sundaysiagian/peruri-iseedesign/robot/jetauto/PYTHON_FILE_CATALOG.md

# Inventaris seluruh file Python

Diambil dari ZIP pengguna. File hanya diparse, entry point ROS dan servo tidak dijalankan.

## original/jetauto_driver/hiwonder_servo/__init__.py

Imports: none

Functions: none

## original/jetauto_driver/hiwonder_servo/hiwonder_servo_controllers/scripts/__init__.py

Imports: none

Functions: none

## original/jetauto_driver/hiwonder_servo/hiwonder_servo_controllers/scripts/controller_manager.py

Imports: hiwonder_servo_controllers.action_group_runner, hiwonder_servo_controllers.joint_position_controller, hiwonder_servo_controllers.joint_trajectory_action_controller, hiwonder_servo_driver.hiwonder_servo_serialproxy, rospy

Functions: none

Class `ControllerManager` (line 9): __init__, on_shutdown, check_deps, start_position_controller, start_trajectory_action_controller, set_multi_pos

## original/jetauto_driver/hiwonder_servo/hiwonder_servo_controllers/scripts/joint_state_publisher.py

Imports: hiwonder_servo_msgs.msg, os, rospy, sensor_msgs.msg

Functions: none

Class `JointStateMessage` (line 8): __init__

Class `JointStatePublisher` (line 15): __init__, controller_state_handler, publish_joint_states

## original/jetauto_driver/hiwonder_servo/hiwonder_servo_controllers/setup.py

Imports: catkin_pkg.python_setup, distutils.core

Functions: none

## original/jetauto_driver/hiwonder_servo/hiwonder_servo_controllers/src/__init__.py

Imports: none

Functions: none

## original/jetauto_driver/hiwonder_servo/hiwonder_servo_controllers/src/hiwonder_servo_controllers/__init__.py

Imports: none

Functions: none

## original/jetauto_driver/hiwonder_servo/hiwonder_servo_controllers/src/hiwonder_servo_controllers/action_group_runner.py

Imports: actionlib, hiwonder_servo_msgs.msg, os, rospy, threading, ujson

Functions: none

Class `ActionGroupRunner` (line 12): __init__, get_actions_from_file, start, runner, process_action_group_run

## original/jetauto_driver/hiwonder_servo/hiwonder_servo_controllers/src/hiwonder_servo_controllers/bus_servo_control.py

Imports: hiwonder_servo_msgs.msg, rospy, signal

Functions: set_servos

## original/jetauto_driver/hiwonder_servo/hiwonder_servo_controllers/src/hiwonder_servo_controllers/joint_controller.py

Imports: hiwonder_servo_msgs.msg, rospy, std_msgs.msg

Functions: none

Class `JointController` (line 10): __init__, initialize, start, stop, process_servo_states, process_command_duration, process_command, rad_to_raw, raw_to_rad

## original/jetauto_driver/hiwonder_servo/hiwonder_servo_controllers/src/hiwonder_servo_controllers/joint_position_controller.py

Imports: hiwonder_servo_controllers.joint_controller, hiwonder_servo_msgs.msg, rospy

Functions: none

Class `JointPositionController` (line 7): __init__, initialize, pos_rad_to_raw, spd_rad_to_raw, process_servo_states, process_command, process_command_duration, set_position, set_position_in_rad

## original/jetauto_driver/hiwonder_servo/hiwonder_servo_controllers/src/hiwonder_servo_controllers/joint_trajectory_action_controller.py

Imports: actionlib, control_msgs.msg, rospy, threading, trajectory_msgs.msg

Functions: none

Class `Segment` (line 12): __init__

Class `JointTrajectoryActionController` (line 20): __init__, initialize, start, stop, process_command, process_follow_trajectory, process_trajectory, update_state

## original/jetauto_driver/hiwonder_servo/hiwonder_servo_driver/setup.py

Imports: catkin_pkg.python_setup, distutils.core

Functions: none

## original/jetauto_driver/hiwonder_servo/hiwonder_servo_driver/src/__init__.py

Imports: none

Functions: none

## original/jetauto_driver/hiwonder_servo/hiwonder_servo_driver/src/hiwonder_servo_driver/__init__.py

Imports: none

Functions: none

## original/jetauto_driver/hiwonder_servo/hiwonder_servo_driver/src/hiwonder_servo_driver/hiwonder_servo_io.py

Imports: os, ros_robot_controller.msg, ros_robot_controller.srv, rospy, sys, time

Functions: none

Class `servo_state` (line 12): __init__

Class `HiwonderServoIO` (line 20): __init__, ping, get_position, get_voltage, get_feedback, set_timeout, set_servo_id, get_servo_id, set_position, stop, set_servo_offset, save_servo_offset, get_servo_offset, set_servo_range, get_servo_range, set_servo_vin_range, get_servo_vin_range, set_servo_temp_range, get_servo_temp_range, get_servo_temp, get_servo_vin, reset_offset, enable_servo_torque, get_servo_torque, exception_on_error

Class `FatalErrorCodeError` (line 381): __init__, __str__

Class `NonfatalErrorCodeError` (line 390): __init__, __str__

Class `ErrorCodeError` (line 399): __init__, __str__

Class `DroppedPacketError` (line 408): __init__, __str__

Class `UnsupportedFeatureError` (line 416): __init__, __str__

## original/jetauto_driver/hiwonder_servo/hiwonder_servo_driver/src/hiwonder_servo_driver/hiwonder_servo_serialproxy.py

Imports: collections, hiwonder_servo_driver, hiwonder_servo_msgs.msg, os, ros_robot_controller.msg, ros_robot_controller.srv, rospy, sys, threading

Functions: none

Class `SerialProxy` (line 14): __init__, id_pos_dur_cb, multi_id_pos_dur_cb, connect, disconnect, __find_motors, __update_servo_states

## original/jetauto_driver/jetauto_controller/scripts/odom_publisher.py

Imports: geometry_msgs.msg, jetauto_sdk.ackermann, jetauto_sdk.mecanum, math, nav_msgs.msg, os, ros_robot_controller.msg, rospy, std_srvs.srv, tf2_ros, threading

Functions: rpy2qua, qua2rpy

Class `Controller` (line 65): __init__, load_calibrate_param, set_odom, app_cmd_vel_callback, cmd_vel_callback, cal_odom_fun

## original/jetauto_driver/jetauto_kinematics/scripts/search_kinematics_solutions_node.py

Imports: geometry_msgs.msg, hiwonder_servo_msgs.msg, jetauto_interfaces.msg, jetauto_interfaces.srv, jetauto_kinematics.forward_kinematics, jetauto_kinematics.inverse_kinematics, jetauto_kinematics.transform, jetauto_sdk, numpy, rospy

Functions: none

Class `SearchKinematicsSolutionsNode` (line 20): __init__, set_link_srv, get_link_srv, set_joint_range_srv, get_joint_range_srv, set_joint_value_target, get_current_pose, get_servo_position, set_pose_target

## original/jetauto_driver/jetauto_kinematics/setup.py

Imports: catkin_pkg.python_setup, distutils.core

Functions: none

## original/jetauto_driver/jetauto_kinematics/src/jetauto_kinematics/__init__.py

Imports: none

Functions: none

## original/jetauto_driver/jetauto_kinematics/src/jetauto_kinematics/kinematics_control.py

Imports: jetauto_interfaces.srv, jetauto_kinematics.transform, rospy

Functions: set_pose_target, set_joint_value_target

## original/jetauto_driver/jetauto_kinematics/src/jetauto_kinematics/kinematics_demo.py

Imports: jetauto_kinematics.forward_kinematics, jetauto_kinematics.inverse_kinematics, jetauto_kinematics.transform

Functions: none

## original/jetauto_driver/jetauto_kinematics/src/jetauto_kinematics/transform.py

Imports: geometry_msgs.msg, math, numpy, os

Functions: isRotationMatrix, rot2rpy, rot2qua, qua2rpy, angle_transform, pulse2angle, angle2pulse

## original/jetauto_driver/jetauto_sdk/setup.py

Imports: catkin_pkg.python_setup, distutils.core

Functions: none

## original/jetauto_driver/jetauto_sdk/src/jetauto_sdk/__init__.py

Imports: none

Functions: none

## original/jetauto_driver/jetauto_sdk/src/jetauto_sdk/ackermann.py

Imports: math, ros_robot_controller.msg

Functions: none

Class `AckermannChassis` (line 7): __init__, speed_covert, set_velocity

## original/jetauto_driver/jetauto_sdk/src/jetauto_sdk/button.py

Imports: Jetson.GPIO, time

Functions: get_button_status

## original/jetauto_driver/jetauto_sdk/src/jetauto_sdk/common.py

Imports: cv2, geometry_msgs.msg, math, numpy, rospy, sensor_msgs.msg, std_msgs.msg, transforms3d, yaml

Functions: loginfo, cv2_image2ros, get_yaml_data, save_yaml_data, distance, box_center, bgr8_to_jpeg, point_remapped, get_area_max_contour, vector_2d_angle, warp_affine, plot_one_box, qua2rpy, rpy2qua, xyz_quat_to_mat, xyz_rot_to_mat, xyz_euler_to_mat, mat_to_xyz_euler

Class `Colors` (line 157): __init__, __call__, hex2rgb

## original/jetauto_driver/jetauto_sdk/src/jetauto_sdk/fps.py

Imports: cv2, time

Functions: none

Class `FPS` (line 6): __init__, update, show_fps

## original/jetauto_driver/jetauto_sdk/src/jetauto_sdk/led.py

Imports: Jetson.GPIO, time

Functions: on, off, set

## original/jetauto_driver/jetauto_sdk/src/jetauto_sdk/mecanum.py

Imports: math, ros_robot_controller.msg

Functions: none

Class `MecanumChassis` (line 7): __init__, speed_covert, set_velocity

## original/jetauto_driver/jetauto_sdk/src/jetauto_sdk/misc.py

Imports: none

Functions: val_map, empty_func, set_range

## original/jetauto_driver/jetauto_sdk/src/jetauto_sdk/pid.py

Imports: time

Functions: none

Class `PID` (line 6): __init__, clear, update, setKp, setKi, setKd, setWindup, setSampleTime

## original/jetauto_driver/ros_robot_controller/scripts/ros_robot_controller_node.py

Imports: math, ros_robot_controller.msg, ros_robot_controller.ros_robot_controller_sdk, ros_robot_controller.srv, rospy, sensor_msgs.msg, std_msgs.msg

Functions: none

Class `ROSRobotController` (line 14): __init__, enable_reception, set_led_state, set_buzzer_state, set_motor_state, set_oled_state, set_pwm_servo_state, get_pwm_servo_state, set_bus_servo_state, get_bus_servo_state, pub_battery_data, pub_button_data, pub_joy_data, pub_sbus_data, pub_imu_data

## original/jetauto_driver/ros_robot_controller/setup.py

Imports: catkin_pkg.python_setup, distutils.core

Functions: none

## original/jetauto_driver/ros_robot_controller/src/ros_robot_controller/ros_robot_controller_sdk.py

Imports: copy, enum, queue, serial, struct, threading, time

Functions: checksum_crc8, bus_servo_test, pwm_servo_test

Class `PacketControllerState` (line 12): 

Class `PacketFunction` (line 23): 

Class `PacketReportKeyEvents` (line 38): 

Class `SBusStatus` (line 75): __init__

Class `Board` (line 83): __init__, packet_report_sys, packet_report_key, packet_report_imu, packet_report_gamepad, packet_report_serial_servo, packet_report_pwm_servo, packet_report_sbus, get_battery, get_button, get_imu, get_gamepad, get_sbus, buf_write, set_led, set_buzzer, set_motor_speed, set_oled_text, pwm_servo_set_position, pwm_servo_set_offset, pwm_servo_read_and_unpack, pwm_servo_read_offset, pwm_servo_read_position, bus_servo_enable_torque, bus_servo_set_id, bus_servo_set_offset, bus_servo_save_offset, bus_servo_set_angle_limit, bus_servo_set_vin_limit, bus_servo_set_temp_limit, bus_servo_stop, bus_servo_set_position, bus_servo_read_and_unpack, bus_servo_read_id, bus_servo_read_offset, bus_servo_read_position, bus_servo_read_vin, bus_servo_read_temp, bus_servo_read_temp_limit, bus_servo_read_angle_limit, bus_servo_read_vin_limit, bus_servo_read_torque_state, enable_reception, recv_task
