sundaysiagian/peruri-iseedesign/evidence/audit/Audit_Bukti_RTL_dan_Klaim_IGOR.docx

# Audit Bukti RTL dan Klaim Proposal IGOR

ISeeDesignITB | Audit bukti per 6 Oktober 2026

Dokumen ini menjawab pertanyaan kesiapan teknis untuk tabel Security Design, metodologi verifikasi, baseline TT07, latensi, daya, memori, neural core, dan jalur ASIC. Status dibedakan menjadi hasil simulasi, hasil implementasi FPGA, proyeksi, dan target integrasi. Masalah komunikasi JetAuto dibahas dalam dokumen terpisah.

## Keputusan yang dapat langsung dipakai

Sembilan kategori fault yang ditanyakan telah memiliki bukti simulasi dengan motor_enable = 0. Audit tambahan memperkuat pemeriksaan keluaran nol dan pencabutan izin aktif untuk replay, alamat tidak berurutan, write setelah lock, dan CRC salah. Status ini berlaku pada skenario yang diuji, bukan seluruh kemungkinan serangan atau sertifikasi keselamatan.

Pertanyaan | Jawaban audit
Latensi DWA | 7.938 siklus pada seluruh enam scene, setara 158,76 µs pada 50 MHz. Worst case normal yang teramati juga 7.938.
Metodologi | Icarus Verilog, oracle integer Python, check procedural, dan waveform GTKWave dipakai. Audit baru menambahkan dua invariant procedural yang dipantau selama simulasi.
Gerbang wajib | Keluaran v_command dan omega_command di igor_top hanya didorong oleh igor_safety_security_gate. Pembacaan command UART memakai keluaran tersebut.
Daya Nano | Power Analyzer berhasil. Estimasi vectorless 506,69 mW dengan confidence Low. Aktivitas HPS/Linux dan konsumsi seluruh board belum diukur.
Neural paralel | Masih proyeksi. Estimasi 8 lane dengan FSM tiga siklus per MAC adalah 2.372 siklus atau 47,44 µs, dengan syarat bandwidth memori yang dijelaskan.
SKY130 dan board | Belum ada laporan sintesis Yosys terpetakan SKY130. Probe JTAG terbaru belum menemukan hardware. Capture JetAuto merupakan bukti komunikasi robot, bukan bukti eksekusi FPGA.

## Ruang lingkup versi

RTL rilis berasal dari outputs/IGOR_DE10_NANO/rtl dengan top igor_uart_top, device 5CSEBA6U23I7, clock 50 MHz. Pengujian tambahan menggunakan RTL yang sama pada salinan proyek. Hash RTL disimpan dalam RTL_SHA256.json. SOF rilis dan proposal utama tetap menjadi artefak terpisah dari audit ini.

# 1 Status Fault Injection

Semua baris berikut berstatus SUDAH DIUJI DALAM SIMULASI untuk skenario spesifik yang disebut. Izin berarti motor_enable. Keluaran nol dibaca langsung dari sinyal gerbang atau LED izin yang dipetakan ke motor_enable. Kasus UART menggunakan clock divider 8 untuk mempercepat simulasi serial.

Fault | Stimulus dan bukti | Hasil dan batas
Replay | MAP-02 pada igor_top_audit_tb. Frame sequence yang sama dengan committed_sequence dikirim setelah hasil normal memperoleh izin. | PASS. Izin 0, v 0, omega 0. Menolak sequence ≤ committed_sequence dalam sesi ini. Tidak membuktikan anti replay kriptografis lintas reset.
Upload terpotong | MAP-07. Hanya satu byte dari frame baru diunggah lalu commit. MAP-03 juga menguji commit tanpa frame lengkap. | PASS. Izin 0, v 0, omega 0. Yang diuji adalah commit frame parsial, bukan setiap variasi putus kabel.
Alamat tidak berurutan | MAP-04. Setelah hasil normal aktif, frame baru dimulai lalu alamat 1 dikirim ketika count mengharapkan 0. | PASS. Izin 0, v 0, omega 0. MAP-06 dan MAP-05 melengkapi alamat di luar batas dan ukuran berlebih.
CRC salah | igor_uart_crc_audit_tb. Setelah command normal aktif, paket A5 opcode 7 diberi CRC FF yang salah. | PASS pada audit UART tambahan. protocol_fault 1, izin 0, v 0, omega 0. CRC mendeteksi error transmisi dan bukan autentikasi.
Write setelah lock | CFG-02. Konfigurasi telah dilock dan hasil normal aktif lalu cfg_write disuntikkan. | PASS. cfg_fault 1, cfg_ok 0, izin 0, v 0, omega 0.
Peta unknown | Scene 2 dengan seluruh 16.384 sel bernilai 255. Sel ≥254 membuat kandidat tidak legal. | PASS. Seluruh kandidat ditolak, izin 0, v 0, omega 0. Tidak berarti setiap peta dengan satu sel unknown selalu berhenti.
Semua kandidat terblokir | Scene 1 dengan semua sel bernilai 254. 512 kandidat dibandingkan dengan oracle. | PASS. best_valid 0, izin 0, v 0, omega 0.
Timeout | TIME-04 menahan done tile 0 hingga melewati deadline. TIME-02 memaksa batas elapsed dan TIME-03 memeriksa lease command. | PASS. Izin 0, v 0, omega 0. Testbench deadline 10.000 siklus, rilis 1.000.000 siklus.
Emergency | SAFE-04 saat RUN dan SAFE-05 sebelum commit hasil. SAFE-06 juga menguji protective_stop. | PASS. Izin 0, v 0, omega 0. Belum diuji tombol dan rangkaian stop pada motor fisik.

# 2 Metodologi dan Batas Verifikasi

## Tool yang benar benar dipakai

Metode | Status | Bukti dan penulisan yang benar
Icarus Verilog | Dipakai | Verilog RTL dan testbench self checking. Audit DWA ulang 12.402 checks, 0 errors. Versi lokal Icarus 12.0 devel.
Python oracle | Dipakai | Model integer independen, 512 kandidat pada masing masing enam scene. Neural diuji dengan 100 vector dan 400 output.
GTKWave dan VCD | Dipakai | Enam screenshot asli pada paket BUKTI_SIMULASI_GTKWAVE. Waveform mendukung pengamatan, hasil PASS berasal dari check testbench.
Assertion procedural | Dipakai pada audit baru | Dua invariant dipantau pada negedge setelah settling 2 ns. Terdapat 556.939 sampel aktif dan nol pelanggaran. Tidak sama dengan formal proof atau SVA lengkap.
Verilator | Belum dipakai | Tidak ada log lint, simulation, atau coverage Verilator pada bukti rilis dan audit ini.
cocotb | Belum dipakai | Testbench berjalan dalam Verilog. Tidak ada regression cocotb yang dijalankan.
Coverage HDL | Belum diukur | Tidak ada angka statement, branch, toggle, FSM, atau coverage formal. Daftar kasus 9 dari 9 hanya cakupan kategori yang diminta.
Formal verification | Belum dilakukan | Tidak ada hasil SymbiYosys atau pembuktian temporal exhaustive. Force pada testbench adalah injeksi simulasi.

## Invariant yang diperiksa

Invariant pertama memeriksa bahwa motor_enable = 0 selalu disertai v_command = 0 dan omega_command = 0 pada sampel simulasi. Invariant kedua memeriksa bahwa setiap izin aktif memenuhi ready, tidak emergency, tidak protective_stop, map_ok, cfg_ok, best_valid, state RESULT, start tidak aktif, seluruh tile done, tidak arithmetic fault, tidak timeout, lease masih berlaku, dan tidak control_fault.

Jumlah check tidak menunjukkan probabilitas gagal di lapangan. Audit tambahan memakai deadline 200 µs dan freshness 5 ms untuk mempercepat fault injection. Rilis memakai 20 ms untuk keduanya. Bukti timeout pada parameter testbench harus disebut dengan jelas.

## Yang masih berstatus target

Target berikut belum selesai: variasi reset dan CDC secara exhaustive, penyerang aktif yang memalsukan sumber, autentikasi dan manajemen kunci, anti replay setelah reboot, pemeriksaan seluruh pola framing serial, uji electrical UART FPGA, watchdog motor controller, latency end to end, serta coverage HDL terukur. Tabel keamanan produk tidak boleh memberi status sudah diuji pada target tersebut.

# 3 Hubungan dengan Baseline Resmi TT07

Referensi baseline di bawah dihubungkan ke bagian desain secara spesifik. Tidak ada instansiasi modul TT07 di RTL IGOR, dan tidak ada benchmark langsung IGOR terhadap implementasi ketiga baseline. Hubungan yang dibuktikan adalah inspirasi arsitektur dan pembandingan konsep.

Baseline | Hubungan dengan IGOR | Perbedaan dan status
TT07 Iterative MAC | Konsep penggunaan ulang unit aritmetika untuk multiply accumulate paling dekat dengan neural core serial. Bobot signed 16 bit dikalikan operand 16 bit lalu dijumlahkan pada accumulator 40 bit. | Referensi TT07 memakai multiplier kecil iteratif. RTL IGOR memakai operator multiply yang dipetakan Quartus. Skor DWA memakai akumulasi penjumlahan dan bobot cost ×16 melalui shift, bukan instansiasi Iterative MAC.
TT07 Mini AIE 2x2 | Empat compute tile menginspirasi pembagian 512 kandidat ke empat rollout evaluator. Tile t mengerjakan indeks t, t+4, hingga t+508. | Mini AIE adalah CGRA dengan Ring NoC dan interface tile. IGOR adalah empat evaluator tetap, broadcast write costmap, empat port baca independen, lalu selector. Tidak ada Ring NoC atau instruction reconfiguration.
TT07 TinyTPU | Baseline konseptual perkalian matriks 2x2 untuk menjelaskan alternatif paralel terhadap neural core serial. | TT07 project 590 milik Revenantx86 dipakai sebagai referensi, bukan IP atau hasil benchmark. Tidak boleh tertukar dengan jofrfu/tinyTPU atau proyek lain bernama TinyTPU.

## Kalimat yang disarankan untuk proposal

Desain IGOR mengambil inspirasi pembagian komputasi dari TT07 Mini AIE 2x2 dan penggunaan ulang aritmetika dari TT07 Iterative MAC. Implementasinya berupa empat evaluator DWA tetap serta neural core serial tersendiri. TT07 TinyTPU menjadi pembanding konsep matrix accelerator untuk pengembangan neural paralel. Ketiga baseline belum dibandingkan melalui benchmark yang sama.

## Sumber primer

[R1] https://www.tinytapeout.com/chips/tt07/tt_um_rajum_iterativeMAC

[R2] https://www.tinytapeout.com/chips/tt07/tt_um_mini_aie_2x2

[R3] https://tinytapeout.com/chips/tt07/tt_um_revenantx86_tinytpu

Halaman dan repositori resmi yang ditautkan diperiksa pada 6 Oktober 2026. Pernyataan implementasi IGOR berasal dari RTL lokal, bukan dari estimasi performa milik baseline.

# 4 Latensi DWA dan Angka Turunan

Scene | Peta | Indeks | Izin | Siklus | Waktu 50 MHz
0 | Peta kosong | 496 | 1 | 7.938 | 158,76 µs
1 | Penuh lethal 254 | 0 | 0 | 7.938 | 158,76 µs
2 | Penuh unknown 255 | 0 | 0 | 7.938 | 158,76 µs
3 | Cost gradien | 450 | 1 | 7.938 | 158,76 µs
4 | Koridor | 496 | 1 | 7.938 | 158,76 µs
5 | Obstacle deterministik | 436 | 1 | 7.938 | 158,76 µs

Setiap tile memproses 128 kandidat. Tiap kandidat melewati INIT satu siklus, 20 pose × tiga state STEP WAIT_RAM SCORE, dan FINISH satu siklus. Total tile adalah 128 × 62 = 7.936 siklus. Kontrol top menambah dua siklus pada counter latency_cycles sehingga hasilnya 7.938.

Kandidat yang tidak legal tetap menjalani seluruh horizon. Isi peta mengubah hasil legal dan skor, tanpa mengubah jadwal state normal. Semua enam scene memiliki minimum, maksimum, dan worst case normal teramati 7.938 siklus. Abort, emergency, error, atau timeout adalah jalur berhenti yang terpisah. Klaim ini tidak mencakup upload peta, UART, HPS, atau motor.

Angka | Perhitungan | Status yang boleh ditulis
64,5 juta evaluasi pose per detik | 512 × 20 / 158,76 µs = 64.499.874 evaluasi/s | Laju ekuivalen kernel normal. Termasuk pose dari kandidat invalid yang tetap dievaluasi. Bukan throughput motor atau upload.
Headroom sekitar 126 kali | 20.000 µs / 158,76 µs = 125,98 | Rasio periode 20 ms terhadap waktu kernel, bukan speedup terhadap CPU atau board lain.
522,60 µs gabungan | (7.938 + 18.192) / 50 MHz | Penjumlahan analitis jika keduanya dijalankan serial tanpa overhead integrasi. Belum diintegrasikan dan belum diukur sebagai pipeline gabungan.

## Kalimat yang aman untuk ringkasan

Pada konfigurasi empat tile dan horizon 20, kernel DWA menyelesaikan enam scene uji dalam 7.938 siklus pada 50 MHz. Ini setara 158,76 µs dan menggunakan sekitar 0,794 persen dari periode kendali 20 ms. Jalur sensor sampai motor masih memerlukan integrasi dan pengukuran tersendiri.

# 5 Jalur Perintah dan Gerbang Keselamatan

Penelusuran RTL tidak menemukan penggerak alternatif untuk motor_enable, v_command, atau omega_command di igor_top. Ketiganya merupakan output wire yang terhubung langsung ke satu instansiasi igor_safety_security_gate. Candidate index, score, serta output neural adalah data internal atau diagnostik yang berbeda dari keluaran command gerbang.

## Rantai yang ditelusuri

igor_rollout_tile ×4 → igor_best_candidate_selector → kandidat v dan omega → igor_safety_security_gate → v_command dan omega_command → vc dan wc di igor_uart_top → payload response opcode 14 → snapshot serial → CRC → UART_TX.

Opcode 14 membentuk response dari {20 bit nol, wc 7 bit, vc 5 bit}. Saat gerbang menolak, kedua nilai command menjadi nol. Status izin juga muncul pada payload status dan LED[0]. Output neural hanya dapat dibaca melalui opcode 12 dan belum mengubah command DWA. Selector index tetap boleh terlihat pada diagnostik meskipun izin nol.

## Klaim yang dapat dipertanggungjawabkan

Setiap keluaran command v dan omega yang disediakan RTL rilis melalui pembacaan opcode 14 berasal dari gerbang safety security. Tidak ada jalur RTL command tersebut yang melewati gerbang. Pernyataan ini dibatasi pada hierarki rilis yang diaudit.

## Batas terhadap motor nyata

Rilis ini belum mengirim paket motor JetAuto secara otomatis dan belum memiliki koneksi enable fisik ke motor controller. Host yang membaca UART FPGA dapat memiliki jalur lain ke robot. Sistem produk harus memaksa motor controller menerima command hanya ketika izin sah, disertai expiry dan watchdog. Audit sumber RTL saja belum membuktikan bahwa seluruh jalur kontrol robot fisik wajib melewati FPGA.

Response serial menggunakan snapshot. Jika emergency atau lease expiry terjadi setelah snapshot command dibuat, frame yang sedang dikirim dapat masih membawa nilai nonzero yang sebelumnya lolos gate. UART_TX tidak menyegarkan payload pada tiap bit. Karena itu klaim gerbang berlaku pada asal data command saat snapshot, bukan jaminan bahwa host selalu menerima nilai sesuai izin terkini. Pencegahan command basi setelah snapshot adalah target integrasi penting.

## Prioritas penolakan

Gate mula mula menetapkan izin dan kedua command ke nol. Urutan pemeriksaan mencakup reset, estop, protective_stop, ready, map_ok, cfg_ok, arithmetic_fault, timeout, all_done dan result_valid, batas kecepatan, serta batas perubahan kecepatan. Keluaran bergerak hanya ditetapkan pada cabang akhir yang lolos seluruh syarat.

KEY[1] menjadi estop asinkron pada top UART, sementara SW menggunakan synchronizer. Uji mekanisme emergency electrical, debounce, dan waktu reaksi motor tetap berstatus target. Tidak ada klaim SIL atau PL dari simulasi ini.

# 6 Replikasi Costmap dan Aktivitas Saat Idle

## Mengapa empat salinan diperlukan

Satu frame berukuran 128 × 128 × 8 bit = 16 KiB. Setiap instansiasi igor_costmap_bank menyediakan dua bank untuk frame aktif dan frame upload, sehingga satu salinan berukuran 32 KiB. Empat tile mendapat satu salinan masing masing, total 4 × 32 KiB = 128 KiB atau 1.048.576 bit costmap logis.

Keempat tile dapat meminta alamat berbeda pada siklus yang sama. Setiap salinan menyediakan satu port baca synchronous tersendiri. Semua write ke inactive bank dibroadcast dengan ram_wr, ram_addr, dan ram_data yang sama. Commit atomik mengubah pemilih active_bank yang dipakai keempat salinan, sehingga evaluator tidak membaca campuran dua frame.

Komponen memori | Ukuran | Bukti implementasi Nano
Satu frame | 16 KiB | 128 × 128 byte
Satu salinan dengan double buffer | 32 KiB | 32768 × 8 bit dalam igor_costmap_bank
Empat salinan | 128 KiB | 32 M10K per salinan, total 128 M10K costmap
Block memory seluruh rilis | 1.051.008 bit data | 128 M10K costmap ditambah 3 M10K neural storage = 131 M10K
Bit fisik yang dialokasikan | 1.341.440 bit | 131 × 10.240 bit. Berbeda dari jumlah bit data logis.

Alternatif berupa arbitrasi akses ke satu memori dapat mengurangi replikasi tetapi mengubah jadwal dan throughput. RAM dual port tidak langsung menyediakan empat port baca independen sekaligus dengan upload. Banking tanpa replikasi perlu menyelesaikan konflik alamat. Alternatif tersebut belum diimplementasikan.

## Clock enable atau clock gating

Clock 50 MHz tidak dimatikan saat tile idle. Banyak register FSM menahan nilai ketika tidak ada assignment, sehingga memiliki perilaku enable register. Itu berbeda dari memutus clock tree. Tidak ada dedicated clock gating yang dikendalikan busy.

igor_costmap_bank selalu memperbarui rd_data pada setiap posedge karena tidak ada if(rd_en). Port write memiliki wr_en. Neural ROM juga selalu clocked. Karena itu tidak boleh menulis bahwa seluruh tile dan memori idle sudah dimatikan clock nya atau bahwa idle power sudah diukur.

Target optimasi daya adalah menambahkan read enable RAM hanya pada fase yang diperlukan, mengurangi switching operand aritmetika, dan mengukur activity idle versus active melalui Power Analyzer. Setiap perubahan harus tetap memenuhi pipeline RAM synchronous dan bit exact regression.

# 7 Neural Serial dan Proyeksi Paralel

Neural 24 → 64 → 64 → 4 membutuhkan 5.888 MAC dan 132 bias. Hasil simulasi 100 vector menyatakan 18.192 siklus atau 363,84 µs per inference pada 50 MHz. RTL memakai satu jalur operand × weight dengan accumulator 40 bit dan tiga state per MAC. Laporan Fitter mengatribusikan 2 DSP pada entitas neural dan 8 DSP pada DWA, total 10 dari 112.

Tidak ada benchmark model yang sama pada ARM Cortex A9, sehingga belum dapat disimpulkan FPGA lebih cepat atau CPU lebih lambat. Baseline CPU harus memakai bobot, input, arithmetic floor Q8.8, saturation, serta clipping output yang sama. Transfer dan overhead host harus dilaporkan terpisah.

## Model proyeksi yang eksplisit

Proyeksi berikut memakai P lane yang mengerjakan neuron berbeda secara paralel, operand input dibroadcast, tiap lane mempunyai accumulator dan bobot independen. FSM tetap tiga siklus per MAC dengan empat siklus overhead per kelompok neuron. Rumus C(P) = ceil(64/P) × 76 + ceil(64/P) × 196 + ceil(4/P) × 196. Untuk P = 1, rumus mengembalikan 18.192 siklus yang terukur.

Lane P | Siklus model | Waktu 50 MHz | Status
1 | 18.192 | 363,84 µs | Implementasi dan simulasi rilis
4 | 4.548 | 90,96 µs | Proyeksi arsitektur
8 | 2.372 | 47,44 µs | Proyeksi arsitektur
16 | 1.284 | 25,68 µs | Proyeksi arsitektur

## Syarat yang belum dibuktikan

Memori harus menyediakan P bobot 16 bit independen setiap fase issue. ROM satu port sekarang tidak memenuhi syarat itu. Bobot perlu dibank atau direplikasi, accumulator dipisah, aktivasi ditulis tanpa konflik, dan urutan penjumlahan tiap neuron dipertahankan untuk bit exactness. Contoh P = 8 memerlukan delapan bobot atau 128 bit per issue.

Sisa 102 DSP merupakan kapasitas yang tersedia pada rilis, bukan jaminan desain paralel berhasil. Lebar multiply, packing DSP, address logic, bandwidth RAM, routing, dan Fmax harus diperiksa melalui sintesis serta Fitter. Tidak boleh mengekstrapolasi jumlah DSP paralel hanya dari satu lane karena sebagian DSP dipakai perhitungan alamat.

Proyeksi ini boleh masuk roadmap dengan label proyeksi analitis belum disintesis. Output neural belum terhubung ke ranking DWA. Prioritas berikutnya adalah prototipe 4 atau 8 lane, pengujian 100 vector, lalu benchmark ARM yang setara.

# 8 Estimasi Daya Quartus Power Analyzer

Power Analyzer Quartus Prime Standard 25.1 build 1129 berhasil dijalankan pada salinan proyek DE10 Nano yang dibangun ulang dari RTL rilis. Build selesai dengan 0 error dan 10 warning. Resource tetap 4.964 ALM, 1.554 register, 131 M10K, dan 10 DSP. Laporan Power Analyzer menyatakan model Final dan confidence Low.

Komponen daya | Estimasi
Total thermal power | 506,69 mW
Core dynamic | 71,96 mW
Core static | 414,18 mW
I O thermal | 20,55 mW
Confidence | Low karena activity toggle yang diberikan belum cukup

## Asumsi dan batas penggunaan angka

Analisis memakai vectorless estimation tanpa VCD atau SAF. Default toggle rate dan input I O toggle rate adalah 12,5 persen, static probability 0,5, ambient 25 °C, dan junction otomatis 28,1 °C. Karakteristik device Typical dengan VCC 1,10 V. Kondisi tegangan dan thermal resistance dicantumkan dalam igor.pow.rpt. Tidak ada board thermal model yang dipilih.

Tool memberi critical warning 215050 karena device memiliki HPS tetapi activity dan konfigurasi daya HPS belum disediakan. Angka 506,69 mW tidak mewakili Linux aktif, DDR3, USB, regulator, sensor, atau seluruh robot. Laporan masih menampilkan sebagian arus static rail HPS. Jangan menamainya daya fabric murni yang telah memisahkan semua rail HPS.

Tool juga memberi warning clock domain yang tidak teridentifikasi pada sebagian node dan tidak adanya board thermal model. Estimasi ini menjawab pertimbangan konsumsi daya sebagai estimasi awal implementasi FPGA. Pengukuran daya board dan activity representative tetap target.

## Kalimat siap pakai

Quartus Power Analyzer memperkirakan total thermal power implementasi DE10 Nano sebesar 506,69 mW, terdiri dari core dynamic 71,96 mW, core static 414,18 mW, dan I O 20,55 mW. Analisis vectorless memiliki confidence Low, belum mencakup aktivitas HPS Linux, dan belum dikonfirmasi oleh pengukuran board.

## Bukti yang disertakan

Folder power berisi igor.pow.summary, igor.pow.rpt, log perintah, igor.fit.summary, igor.sta.summary, dan igor.qsf. Perintah berhasil tercatat dalam power_vectorless.log. SOF rilis sebelumnya tidak diganti oleh hasil build audit.

# 9 Jalur ASIC dan Status Uji Fisik

## Yosys dan SkyWater SKY130

Belum ada hasil sintesis Yosys ke library SkyWater SKY130 pada paket ini. Tidak tersedia laporan sel terpetakan, luas µm², SRAM macro area, STA ASIC, place and route, DRC, LVS, atau GDS. Status yang boleh ditulis adalah RTL sudah diuji dan diimplementasikan pada FPGA, sedangkan estimasi ASIC masih target.

Portabilitas RTL aritmetika dan kontrol memberi jalur menuju ASIC, tetapi ramstyle M10K dan ROM readmemh adalah kontrak implementasi FPGA. Costmap 128 KiB memerlukan strategi SRAM macro serta banking ASIC. Memetakan seluruh memori menjadi flip flop dapat membuat luas sangat besar dan tidak mewakili implementasi macro yang realistis.

## Tahap berikutnya yang menghasilkan bukti ASIC

1. Tentukan boundary ASIC, clock, reset, I O, dan apakah memori berada di dalam atau di luar core.

2. Pisahkan modul kontrol serta aritmetika yang portable dari wrapper FPGA. Tentukan memory wrapper dan SRAM macro yang benar benar tersedia.

3. Jalankan Yosys dengan library SKY130 dan laporkan top, hash sumber, versi tool, library, jumlah sel, serta luas logic. Laporkan memori yang dikecualikan secara eksplisit.

4. Jalankan STA dan place and route dengan constraint yang ditentukan. Sertakan luas memory macro dan overhead fisik sebelum memberi angka total chip.

5. Ulangi regression pada netlist bila tersedia. GDS dan tapeout readiness memerlukan validasi fisik yang lebih lengkap.

## Uji board sebelum 8 Oktober

Probe Quartus Programmer tanggal audit melaporkan No JTAG hardware available. Belum ada foto, log download SOF, command FPGA melalui UART electrical, atau motor test yang lulus. Capture JetAuto dari COM9 menunjukkan penerimaan data controller robot dan tidak membuktikan SOF pernah dijalankan pada FPGA.

Saat board tersedia, bukti minimal yang dibutuhkan adalah foto board dan wiring, device JTAG yang terdeteksi, log programming SOF dengan hash, satu upload dan command readout yang berhasil, lalu emergency yang menyebabkan izin dan command nol. Pengujian motor serta deadline end to end adalah penerimaan terpisah. COM9 belum dibuka pada audit ini.

# 10 Ringkasan Status untuk Tabel Proposal

Pernyataan | Status yang benar
Sembilan kategori fault menghasilkan izin nol | Sudah diuji pada skenario simulasi yang dijelaskan
CRC dan sequence membuat kanal autentik | Target autentikasi. Klaim saat ini tidak didukung
DWA selalu 7.938 siklus pada keenam scene | Sudah diuji untuk konfigurasi empat tile horizon 20 dan jalur normal
Semua command v omega RTL melalui gate | Didukung penelusuran RTL dan invariant simulasi pada hierarki rilis
Semua command robot fisik wajib melewati FPGA | Target integrasi host dan motor controller
Daya 506,69 mW | Estimasi Quartus vectorless confidence Low
Clock tile idle sudah dimatikan | Tidak diterapkan. Register hold ada, RAM read tetap clocked
Neural 8 lane 47,44 µs | Proyeksi analitis dengan memori multi lane, belum disintesis
Lebih cepat daripada ARM | Belum dibandingkan pada benchmark yang setara
SKY130 area dan cell count tersedia | Belum diuji, masih target
FPGA fisik atau motor sudah diuji | Belum ada bukti PASS. Jangan ditulis sudah diuji

## Bukti lokal yang menjadi dasar

Audit baru: top_audit.log, uart_audit.log, test_summary.csv, scene_latency.csv, dua testbench audit, dan RTL_SHA256.json. Laporan rilis: igor.fit.rpt dan RTL top gate tile costmap neural. Bukti lama: logs pada BUKTI_SIMULASI_GTKWAVE serta board_test_log.txt. Power audit: folder power.

Sumber eksternal R1 sampai R3 dicantumkan pada bagian baseline. Angka performa dan fault berasal dari bukti lokal. Capture dan diagnosis UART JetAuto hanya dimuat dalam dokumen Diagnosis UART JetAuto dari Capture Pasif.

## Reproduksi

Folder reproduction menyediakan RTL, assets, vector, testbench, dan Run-Audit.ps1. Jalankan dengan Icarus iverilog dan vvp tersedia. Hasil PASS harus diperiksa dari log, bukan hanya exit code simulator. Invariant tambahan mengamati trace simulasi dan tidak menggantikan formal verification.
