sundaysiagian/peruri-iseedesign/docs/README.md

# Pusat dokumentasi IGOR

Dokumentasi ini disusun untuk pembaca yang ingin menilai hasil, menjalankan simulasi, membuka Quartus, atau mengambil alih pengembangan hardware.

| Jika Anda ingin | Baca |
|---|---|
| Menjalankan hasil dalam beberapa langkah | [Quickstart](QUICKSTART.md) |
| Memahami alur dan lebar data | [Arsitektur](ARCHITECTURE.md) |
| Menemukan top module dan setiap blok RTL | [Modul RTL](RTL_MODULES.md) |
| Memprogram Nano atau Lite | [Programming FPGA](FPGA_PROGRAMMING.md) |
| Memeriksa metodologi dan fault injection | [Verifikasi](VERIFICATION.md) |
| Membaca resource, latency, dan power | [Performa](PERFORMANCE.md) |
| Menelusuri screenshot dan laporan asli | [Indeks bukti](EVIDENCE.md) |
| Menyiapkan demo dan rekaman 3–5 menit | [Panduan demo](DEMO_GUIDE.md) |
| Mempelajari komunikasi STM dan empat RPM | [JetAuto](JETAUTO.md) |
| Melanjutkan prototipe chip | [TinyTapeout](TINYTAPEOUT.md) dan [datasheet register](info.md) |
| Menggunakan laporan ringkas untuk penilaian | [Laporan teknis](TECHNICAL_REPORT.md) |
| Mengambil alih proyek | [Knowledge](KNOWLEDGE.md) |
| Menyiapkan cerita pencapaian | [Achievements](ACHIEVEMENTS.md) |
| Memahami cakupan hasil dan acceptance | [Hasil dan cakupan](RESULTS_AND_SCOPE.md) |
| Melacak sumber desain | [Referensi](REFERENCES.md) |

Diagram lengkap: [IGOR_RTL_Flowchart.io](flowcharts/IGOR_RTL_Flowchart.io), 28 halaman dalam satu file yang dapat dibuka di diagrams.net.

Kembali ke [README utama](../README.md).
