sundaysiagian/peruri-iseedesign/evidence/quartus/arsitektur_hps_fpga.png

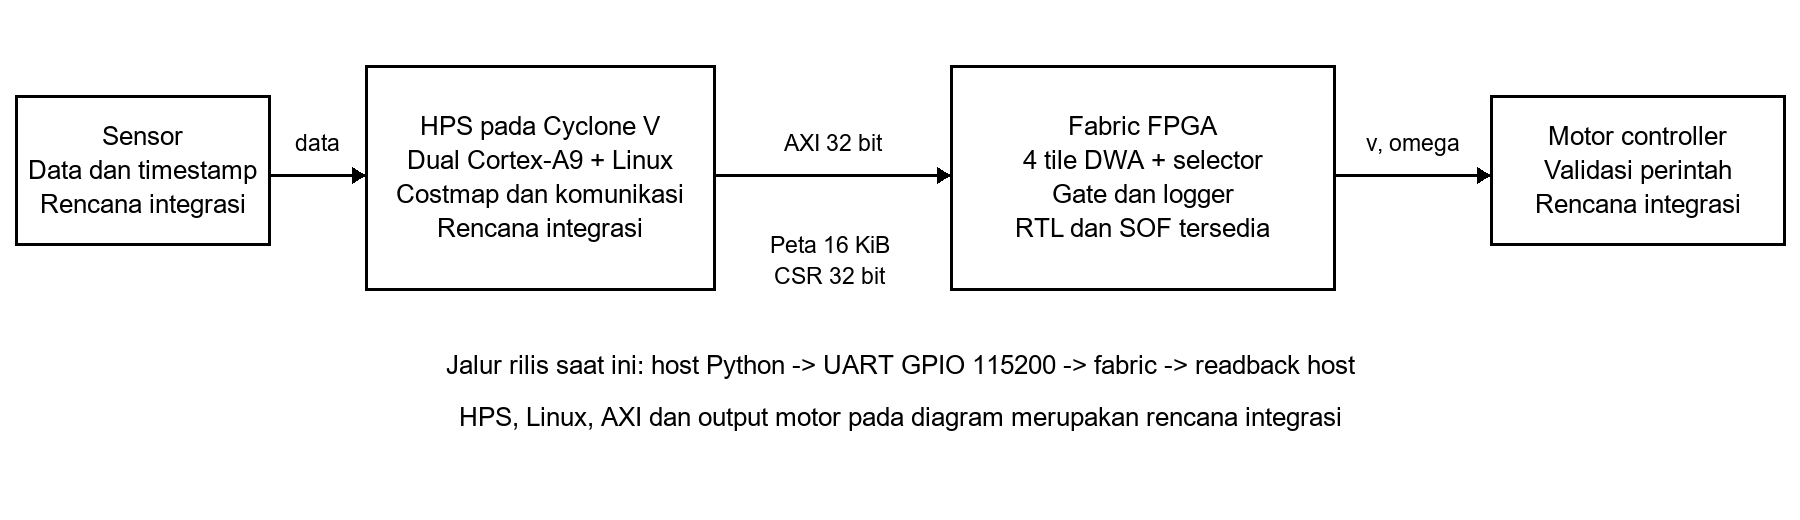
evidence/quartus/arsitektur_hps_fpga.png
