sundaysiagian/peruri-iseedesign/evidence/waveforms/01_dwa_normal.png

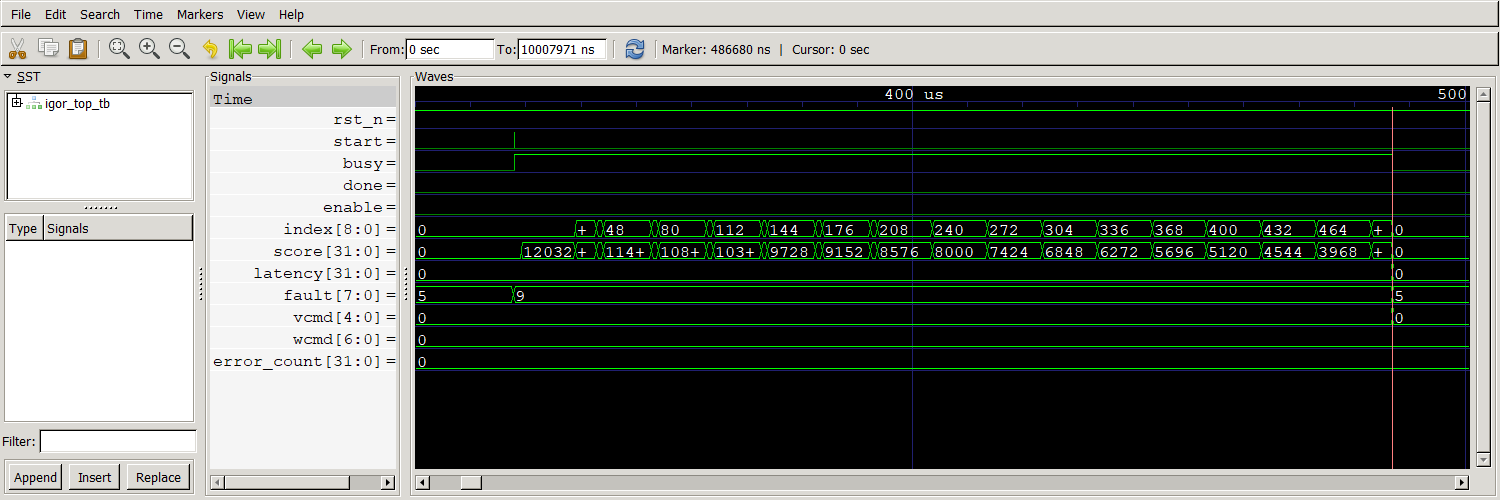
evidence/waveforms/01_dwa_normal.png
