sundaysiagian/peruri-iseedesign/evidence/waveforms/03_neural.png

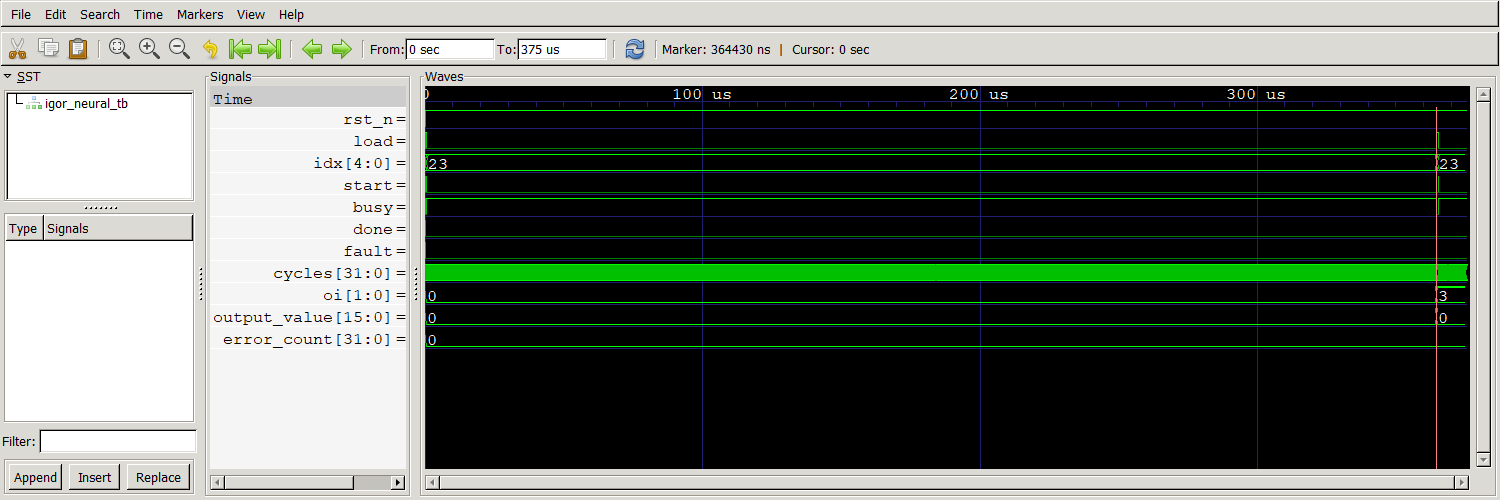
evidence/waveforms/03_neural.png
