sundaysiagian/peruri-iseedesign/evidence/waveforms/04_uart.png

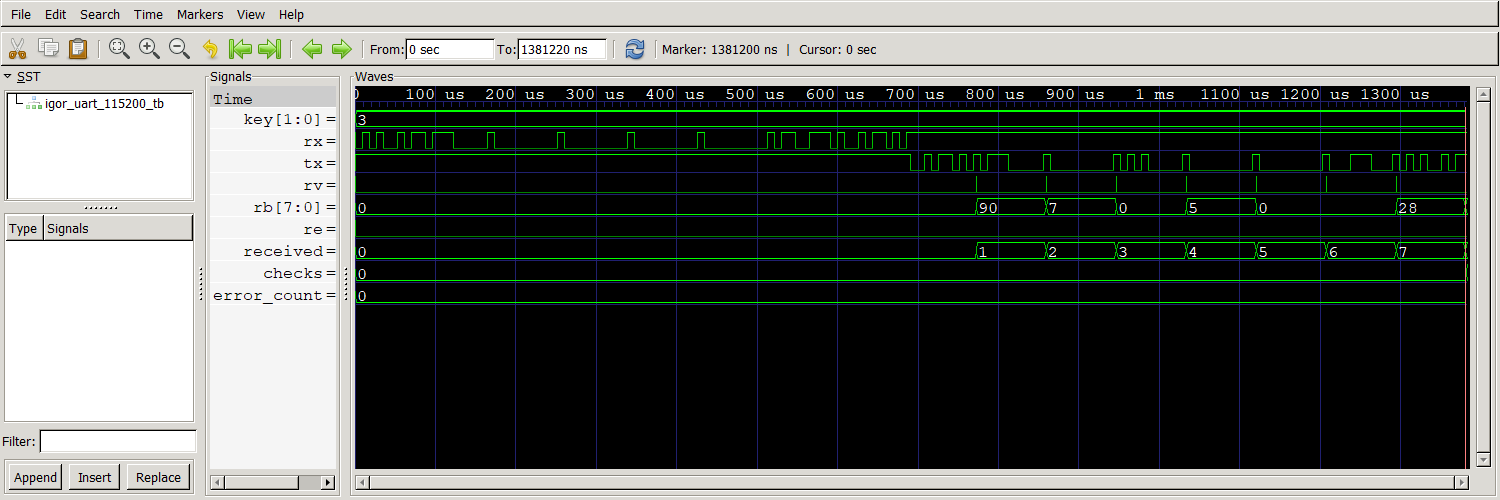
evidence/waveforms/04_uart.png
