sundaysiagian/peruri-iseedesign/notebook/outputs/run_20261008_160243/visualizations/ood1_negative_x.gif

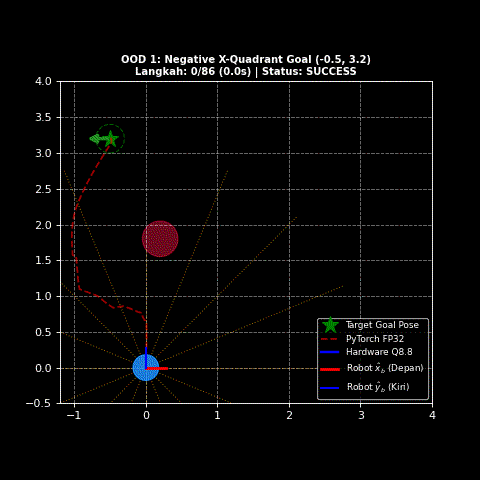
notebook/outputs/run_20261008_160243/visualizations/ood1_negative_x.gif
