sundaysiagian/peruri-iseedesign/notebook/outputs/run_20261008_160243/visualizations/ood2_5obstacle_maze.gif

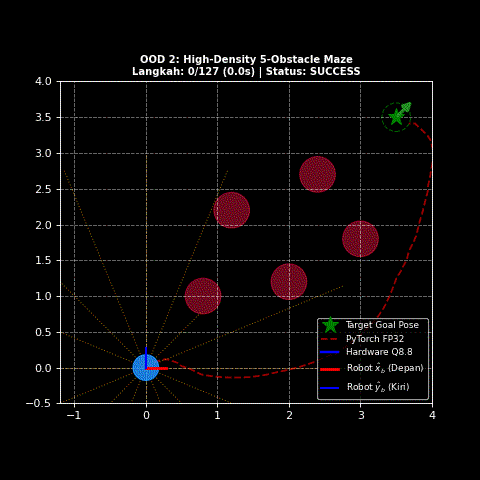
notebook/outputs/run_20261008_160243/visualizations/ood2_5obstacle_maze.gif
