sundaysiagian/peruri-iseedesign/notebook/outputs/run_20261008_160243/visualizations/ood3_heterogeneous_radius.gif

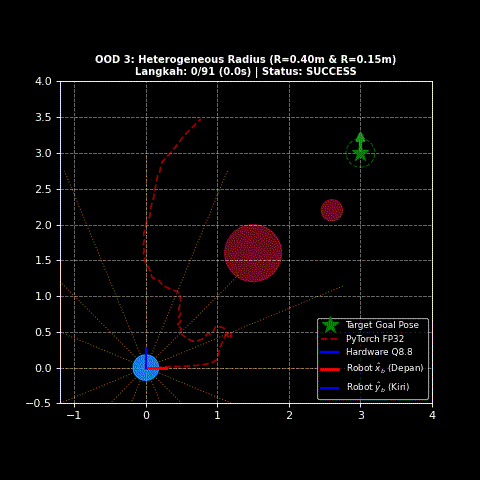
notebook/outputs/run_20261008_160243/visualizations/ood3_heterogeneous_radius.gif
