sundaysiagian/peruri-iseedesign/notebook/outputs/run_20261008_160243/visualizations/ood4_slalom_barrier.gif

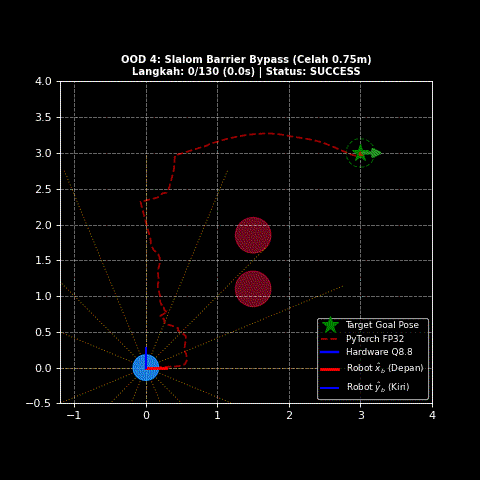
notebook/outputs/run_20261008_160243/visualizations/ood4_slalom_barrier.gif
