sundaysiagian/peruri-iseedesign/notebook/outputs/run_20261008_160243/visualizations/telemetry_dashboard.png

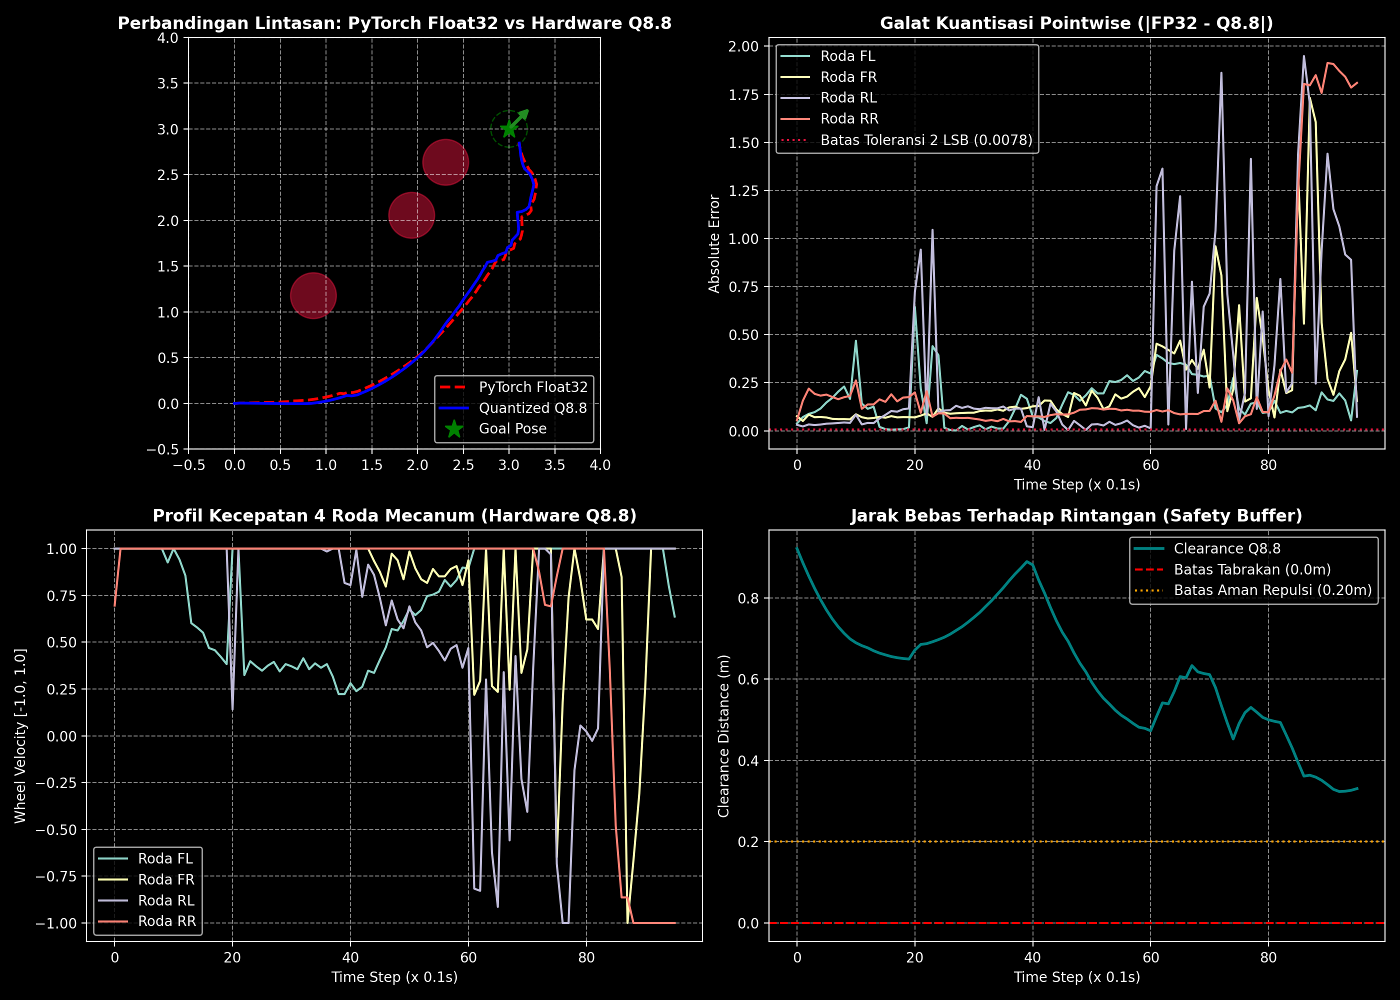
notebook/outputs/run_20261008_160243/visualizations/telemetry_dashboard.png
