sundaysiagian/peruri-iseedesign/fpga_de10_lite/sources/MANUAL_URL.txt

https://faculty-web.msoe.edu/johnsontimoj/Common/FILES/DE10_Lite_User_Manual.pdf
