sundaysiagian/peruri-iseedesign/evidence/audit/fault_result_excerpt.csv

case | time_ps | expected | actual | status | motor_enable | v_command | omega_command
MAP-07 partial rejects | 3406811000 | 1 | 1 | PASS | 0 | 0 | 0
MAP-04 missing byte | 3893740000 | 1 | 1 | PASS | 0 | 0 | 0
MAP-02 replay | 4380640000 | 1 | 1 | PASS | 0 | 0 | 0
CFG-02 locked write | 6009700000 | 1 | 1 | PASS | 0 | 0 | 0
TIME-04 missing tile timeout | 6865831000 | 1 | 1 | PASS | 0 | 0 | 0
SAFE-04 estop during run | 7850581000 | 2 | 2 | PASS | 0 | 0 | 0
