sundaysiagian/peruri-iseedesign/fpga_de10_lite/evidence/test_summary.csv

case | time_ns | expected | actual | status
SAFE-01 reset | 51000 | 0 | 0 | PASS
MAP-01 valid commit | 327891000 | 1 | 1 | PASS
candidate tile3 valid | 329160000 | 1 | 1 | PASS
candidate tile3 score | 329160000 | 12032 | 12032 | PASS
candidate tile3 cost | 329160000 | 0 | 0 | PASS
candidate tile3 goal | 329160000 | 8192 | 8192 | PASS
candidate tile3 goal | 329160000 | 8192 | 8192 | PASS
candidate tile2 score | 329160000 | 12032 | 12032 | PASS
candidate tile2 cost | 329160000 | 0 | 0 | PASS
candidate tile2 goal | 329160000 | 8192 | 8192 | PASS
candidate tile2 goal | 329160000 | 8192 | 8192 | PASS
candidate tile1 score | 329160000 | 12032 | 12032 | PASS
candidate tile1 cost | 329160000 | 0 | 0 | PASS
candidate tile1 goal | 329160000 | 8192 | 8192 | PASS
candidate tile1 goal | 329160000 | 8192 | 8192 | PASS
candidate tile0 score | 329160000 | 12032 | 12032 | PASS
candidate tile0 cost | 329160000 | 0 | 0 | PASS
candidate tile0 goal | 329160000 | 8192 | 8192 | PASS
candidate tile0 valid | 330400000 | 1 | 1 | PASS
candidate tile0 score | 330400000 | 12032 | 12032 | PASS
candidate tile0 cost | 330400000 | 0 | 0 | PASS
candidate tile0 goal | 330400000 | 8192 | 8192 | PASS
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
