sundaysiagian/peruri-iseedesign/evidence/audit/test_summary.csv

case | time_ps | expected | actual | status | motor_enable | v_command | omega_command
SAFE-01 reset | 51000 | 0 | 0 | PASS | 0 | 0 | 0
MAP-01 valid commit | 327891000 | 1 | 1 | PASS | 0 | 0 | 0
candidate tile3 valid | 329160000 | 1 | 1 | PASS | 0 | 0 | 0
candidate tile3 score | 329160000 | 12032 | 12032 | PASS | 0 | 0 | 0
candidate tile3 cost | 329160000 | 0 | 0 | PASS | 0 | 0 | 0
candidate tile3 goal | 329160000 | 8192 | 8192 | PASS | 0 | 0 | 0
candidate tile3 goal | 329160000 | 8192 | 8192 | PASS | 0 | 0 | 0
candidate tile2 score | 329160000 | 12032 | 12032 | PASS | 0 | 0 | 0
candidate tile2 cost | 329160000 | 0 | 0 | PASS | 0 | 0 | 0
candidate tile2 goal | 329160000 | 8192 | 8192 | PASS | 0 | 0 | 0
candidate tile2 goal | 329160000 | 8192 | 8192 | PASS | 0 | 0 | 0
candidate tile1 score | 329160000 | 12032 | 12032 | PASS | 0 | 0 | 0
candidate tile1 cost | 329160000 | 0 | 0 | PASS | 0 | 0 | 0
candidate tile1 goal | 329160000 | 8192 | 8192 | PASS | 0 | 0 | 0
candidate tile1 goal | 329160000 | 8192 | 8192 | PASS | 0 | 0 | 0
candidate tile0 score | 329160000 | 12032 | 12032 | PASS | 0 | 0 | 0
candidate tile0 cost | 329160000 | 0 | 0 | PASS | 0 | 0 | 0
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
