sundaysiagian/peruri-iseedesign/notebook/outputs/run_20261008_160243/visualizations/unique_scenarios_validation.png

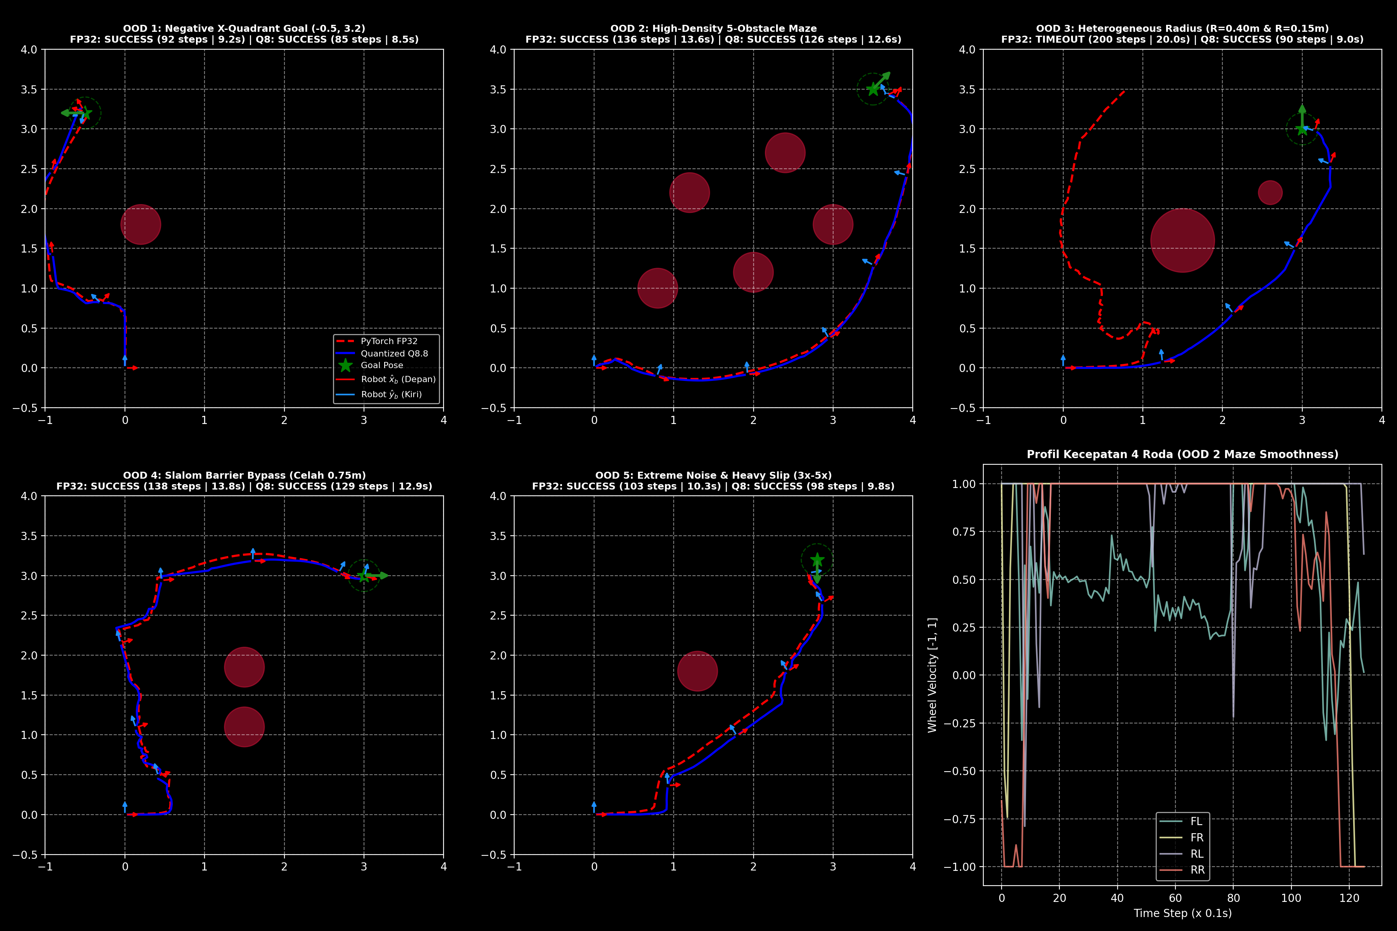
notebook/outputs/run_20261008_160243/visualizations/unique_scenarios_validation.png
