sundaysiagian/peruri-iseedesign/robot/jetauto/FPGA_UART_TTL_MULTISPEED/rtl/stm_packet_tx_multispeed.v

// Fixed SDK-equivalent packets. UART 8N1, 50 clocks/bit at 50 MHz.
module stm_packet_tx_multispeed #(parameter CLKS_PER_BIT=50)(
 input wire clk, input wire reset, input wire start, input wire [1:0] command,input wire [1:0] speed_level,
 output reg tx, output reg busy, output reg done);
 reg [3:0] selected;
 wire [3:0] requested_bank=command<2 ? {2'b00,command} : 4'd2+{1'b0,speed_level,1'b0}+{3'b000,command[0]};
 reg [4:0] index;
 reg [3:0] bit_index;
 reg [15:0] timer;
 reg [9:0] shift;
 wire [4:0] last_index = selected == 4'd1 ? 5'd12 : 5'd26;
 function [7:0] rom_byte;
 input [8:0] address;
 begin
  case(address)
      9'd0: rom_byte = 8'haa;
      9'd1: rom_byte = 8'h55;
      9'd2: rom_byte = 8'h03;
      9'd3: rom_byte = 8'h16;
      9'd4: rom_byte = 8'h01;
      9'd5: rom_byte = 8'h04;
      9'd6: rom_byte = 8'h00;
      9'd7: rom_byte = 8'h00;
      9'd8: rom_byte = 8'h00;
      9'd9: rom_byte = 8'h00;
      9'd10: rom_byte = 8'h00;
      9'd11: rom_byte = 8'h01;
      9'd12: rom_byte = 8'h00;
      9'd13: rom_byte = 8'h00;
      9'd14: rom_byte = 8'h00;
      9'd15: rom_byte = 8'h00;
      9'd16: rom_byte = 8'h02;
      9'd17: rom_byte = 8'h00;
      9'd18: rom_byte = 8'h00;
      9'd19: rom_byte = 8'h00;
      9'd20: rom_byte = 8'h00;
      9'd21: rom_byte = 8'h03;
      9'd22: rom_byte = 8'h00;
      9'd23: rom_byte = 8'h00;
      9'd24: rom_byte = 8'h00;
      9'd25: rom_byte = 8'h00;
      9'd26: rom_byte = 8'h07;
      9'd32: rom_byte = 8'haa;
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
      9'd313: rom_byte = 8'h3f;
      9'd314: rom_byte = 8'h40;
   default: rom_byte=0;
  endcase
 end
 endfunction
 always @(posedge clk) begin
  if(reset) begin tx<=1; busy<=0; done<=0; selected<=0; index<=0; bit_index<=0; timer<=0; shift<=10'h3ff; end
  else begin
   done<=0;
   if(!busy) begin
    tx<=1;
    if(start) begin
     selected<=requested_bank; index<=0; bit_index<=0; timer<=CLKS_PER_BIT[15:0]-16'd1;
     shift<={1'b1,rom_byte({requested_bank,5'd0}),1'b0}; tx<=0; busy<=1;
    end
   end else if(timer != 0) timer<=timer-1'b1;
   else begin
    timer<=CLKS_PER_BIT[15:0]-16'd1;
    if(bit_index != 9) begin shift<={1'b1,shift[9:1]}; tx<=shift[1]; bit_index<=bit_index+1'b1; end
    else if(index==last_index) begin busy<=0; done<=1; tx<=1; end
    else begin
     index<=index+1'b1; bit_index<=0;
     shift<={1'b1,rom_byte({selected,index+5'd1}),1'b0}; tx<=0;
    end
   end
  end
 end
endmodule
