sundaysiagian/peruri-iseedesign/ImplementationReadyQuartus/IGOR_DE10_NANO/rtl/igor_trig_lut.v

// William Anthony
// 13223048
// ISeeDesignITB
`timescale 1ns/1ps
`default_nettype none
module igor_trig_lut(input wire [7:0] phase,output reg signed [15:0] value);
always @(*) begin
 case(phase)
 8'd0: value=16'sh0000;
 8'd1: value=16'sh0192;
 8'd2: value=16'sh0324;
 8'd3: value=16'sh04b5;
 8'd4: value=16'sh0646;
 8'd5: value=16'sh07d6;
 8'd6: value=16'sh0964;
 8'd7: value=16'sh0af1;
 8'd8: value=16'sh0c7c;
 8'd9: value=16'sh0e06;
 8'd10: value=16'sh0f8d;
 8'd11: value=16'sh1112;
 8'd12: value=16'sh1294;
 8'd13: value=16'sh1413;
 8'd14: value=16'sh1590;
 8'd15: value=16'sh1709;
 8'd16: value=16'sh187e;
 8'd17: value=16'sh19ef;
 8'd18: value=16'sh1b5d;
 8'd19: value=16'sh1cc6;
 8'd20: value=16'sh1e2b;
 8'd21: value=16'sh1f8c;
 8'd22: value=16'sh20e7;
 8'd23: value=16'sh223d;
 8'd24: value=16'sh238e;
 8'd25: value=16'sh24da;
 8'd26: value=16'sh2620;
 8'd27: value=16'sh2760;
 8'd28: value=16'sh289a;
 8'd29: value=16'sh29ce;
 8'd30: value=16'sh2afb;
 8'd31: value=16'sh2c21;
 8'd32: value=16'sh2d41;
 8'd33: value=16'sh2e5a;
 8'd34: value=16'sh2f6c;
 8'd35: value=16'sh3076;
 8'd36: value=16'sh3179;
 8'd37: value=16'sh3274;
 8'd38: value=16'sh3368;
 8'd39: value=16'sh3453;
 8'd40: value=16'sh3537;
 8'd41: value=16'sh3612;
 8'd42: value=16'sh36e5;
 8'd43: value=16'sh37b0;
 8'd44: value=16'sh3871;
 8'd45: value=16'sh392b;
 8'd46: value=16'sh39db;
 8'd47: value=16'sh3a82;
 8'd48: value=16'sh3b21;
 8'd49: value=16'sh3bb6;
 8'd50: value=16'sh3c42;
 8'd51: value=16'sh3cc5;
 8'd52: value=16'sh3d3f;
 8'd53: value=16'sh3daf;
 8'd54: value=16'sh3e15;
 8'd55: value=16'sh3e72;
 8'd56: value=16'sh3ec5;
 8'd57: value=16'sh3f0f;
 8'd58: value=16'sh3f4f;
 8'd59: value=16'sh3f85;
 8'd60: value=16'sh3fb1;
 8'd61: value=16'sh3fd4;
 8'd62: value=16'sh3fec;
 8'd63: value=16'sh3ffb;
 8'd64: value=16'sh4000;
 8'd65: value=16'sh3ffb;
 8'd66: value=16'sh3fec;
 8'd67: value=16'sh3fd4;
 8'd68: value=16'sh3fb1;
 8'd69: value=16'sh3f85;
 8'd70: value=16'sh3f4f;
 8'd71: value=16'sh3f0f;
 8'd72: value=16'sh3ec5;
 8'd73: value=16'sh3e72;
 8'd74: value=16'sh3e15;
 8'd75: value=16'sh3daf;
 8'd76: value=16'sh3d3f;
 8'd77: value=16'sh3cc5;
 8'd78: value=16'sh3c42;
 8'd79: value=16'sh3bb6;
 8'd80: value=16'sh3b21;
 8'd81: value=16'sh3a82;
 8'd82: value=16'sh39db;
 8'd83: value=16'sh392b;
 8'd84: value=16'sh3871;
 8'd85: value=16'sh37b0;
 8'd86: value=16'sh36e5;
 8'd87: value=16'sh3612;
 8'd88: value=16'sh3537;
 8'd89: value=16'sh3453;
 8'd90: value=16'sh3368;
 8'd91: value=16'sh3274;
 8'd92: value=16'sh3179;
 8'd93: value=16'sh3076;
 8'd94: value=16'sh2f6c;
 8'd95: value=16'sh2e5a;
 8'd96: value=16'sh2d41;
 8'd97: value=16'sh2c21;
 8'd98: value=16'sh2afb;
 8'd99: value=16'sh29ce;
 8'd100: value=16'sh289a;
 8'd101: value=16'sh2760;
 8'd102: value=16'sh2620;
 8'd103: value=16'sh24da;
 8'd104: value=16'sh238e;
 8'd105: value=16'sh223d;
 8'd106: value=16'sh20e7;
 8'd107: value=16'sh1f8c;
 8'd108: value=16'sh1e2b;
 8'd109: value=16'sh1cc6;
 8'd110: value=16'sh1b5d;
 8'd111: value=16'sh19ef;
 8'd112: value=16'sh187e;
 8'd113: value=16'sh1709;
 8'd114: value=16'sh1590;
 8'd115: value=16'sh1413;
 8'd116: value=16'sh1294;
 8'd117: value=16'sh1112;
 8'd118: value=16'sh0f8d;
 8'd119: value=16'sh0e06;
 8'd120: value=16'sh0c7c;
 8'd121: value=16'sh0af1;
 8'd122: value=16'sh0964;
 8'd123: value=16'sh07d6;
 8'd124: value=16'sh0646;
 8'd125: value=16'sh04b5;
 8'd126: value=16'sh0324;
 8'd127: value=16'sh0192;
 8'd128: value=16'sh0000;
 8'd129: value=16'shfe6e;
 8'd130: value=16'shfcdc;
 8'd131: value=16'shfb4b;
 8'd132: value=16'shf9ba;
 8'd133: value=16'shf82a;
 8'd134: value=16'shf69c;
 8'd135: value=16'shf50f;
 8'd136: value=16'shf384;
 8'd137: value=16'shf1fa;
 8'd138: value=16'shf073;
 8'd139: value=16'sheeee;
 8'd140: value=16'shed6c;
 8'd141: value=16'shebed;
 8'd142: value=16'shea70;
 8'd143: value=16'she8f7;
 8'd144: value=16'she782;
 8'd145: value=16'she611;
 8'd146: value=16'she4a3;
 8'd147: value=16'she33a;
 8'd148: value=16'she1d5;
 8'd149: value=16'she074;
 8'd150: value=16'shdf19;
 8'd151: value=16'shddc3;
 8'd152: value=16'shdc72;
 8'd153: value=16'shdb26;
 8'd154: value=16'shd9e0;
 8'd155: value=16'shd8a0;
 8'd156: value=16'shd766;
 8'd157: value=16'shd632;
 8'd158: value=16'shd505;
 8'd159: value=16'shd3df;
 8'd160: value=16'shd2bf;
 8'd161: value=16'shd1a6;
 8'd162: value=16'shd094;
 8'd163: value=16'shcf8a;
 8'd164: value=16'shce87;
 8'd165: value=16'shcd8c;
 8'd166: value=16'shcc98;
 8'd167: value=16'shcbad;
 8'd168: value=16'shcac9;
 8'd169: value=16'shc9ee;
 8'd170: value=16'shc91b;
 8'd171: value=16'shc850;
 8'd172: value=16'shc78f;
 8'd173: value=16'shc6d5;
 8'd174: value=16'shc625;
 8'd175: value=16'shc57e;
 8'd176: value=16'shc4df;
 8'd177: value=16'shc44a;
 8'd178: value=16'shc3be;
 8'd179: value=16'shc33b;
 8'd180: value=16'shc2c1;
 8'd181: value=16'shc251;
 8'd182: value=16'shc1eb;
 8'd183: value=16'shc18e;
 8'd184: value=16'shc13b;
 8'd185: value=16'shc0f1;
 8'd186: value=16'shc0b1;
 8'd187: value=16'shc07b;
 8'd188: value=16'shc04f;
 8'd189: value=16'shc02c;
 8'd190: value=16'shc014;
 8'd191: value=16'shc005;
 8'd192: value=16'shc000;
 8'd193: value=16'shc005;
 8'd194: value=16'shc014;
 8'd195: value=16'shc02c;
 8'd196: value=16'shc04f;
 8'd197: value=16'shc07b;
 8'd198: value=16'shc0b1;
 8'd199: value=16'shc0f1;
 8'd200: value=16'shc13b;
 8'd201: value=16'shc18e;
 8'd202: value=16'shc1eb;
 8'd203: value=16'shc251;
 8'd204: value=16'shc2c1;
 8'd205: value=16'shc33b;
 8'd206: value=16'shc3be;
 8'd207: value=16'shc44a;
 8'd208: value=16'shc4df;
 8'd209: value=16'shc57e;
 8'd210: value=16'shc625;
 8'd211: value=16'shc6d5;
 8'd212: value=16'shc78f;
 8'd213: value=16'shc850;
 8'd214: value=16'shc91b;
 8'd215: value=16'shc9ee;
 8'd216: value=16'shcac9;
 8'd217: value=16'shcbad;
 8'd218: value=16'shcc98;
 8'd219: value=16'shcd8c;
 8'd220: value=16'shce87;
 8'd221: value=16'shcf8a;
 8'd222: value=16'shd094;
 8'd223: value=16'shd1a6;
 8'd224: value=16'shd2bf;
 8'd225: value=16'shd3df;
 8'd226: value=16'shd505;
 8'd227: value=16'shd632;
 8'd228: value=16'shd766;
 8'd229: value=16'shd8a0;
 8'd230: value=16'shd9e0;
 8'd231: value=16'shdb26;
 8'd232: value=16'shdc72;
 8'd233: value=16'shddc3;
 8'd234: value=16'shdf19;
 8'd235: value=16'she074;
 8'd236: value=16'she1d5;
 8'd237: value=16'she33a;
 8'd238: value=16'she4a3;
 8'd239: value=16'she611;
 8'd240: value=16'she782;
 8'd241: value=16'she8f7;
 8'd242: value=16'shea70;
 8'd243: value=16'shebed;
 8'd244: value=16'shed6c;
 8'd245: value=16'sheeee;
 8'd246: value=16'shf073;
 8'd247: value=16'shf1fa;
 8'd248: value=16'shf384;
 8'd249: value=16'shf50f;
 8'd250: value=16'shf69c;
 8'd251: value=16'shf82a;
 8'd252: value=16'shf9ba;
 8'd253: value=16'shfb4b;
 8'd254: value=16'shfcdc;
 8'd255: value=16'shfe6e;
 default: value=16'sd0;
 endcase
end
endmodule
`default_nettype wire
