sundaysiagian/peruri-iseedesign/(commit log)

2026-10-07 feat: Tambahkan seluruh file project
    [c5_pin_model_dump.txt, calibrate_params.yaml, candidate_trace.csv, fault_result_excerpt.csv, fault_status.csv, hiwonder_servo_controller.yaml, hiwonder_servo_controller_without_arm.yaml, scene_latency.csv]
2026-10-07 feat: Perbagus Tampilans
    [c5_pin_model_dump.txt]
2026-10-07 feat: proyek referensi menerima UART dan mengendalikan buzzer lokal. Proyek motor mengirim UART ke STM. Perbedaan fungsi pin E8 sudah jelas.
    [com9_packet_rx.v, de10_nano_uart_buzzer.v, tb_uart_gpio_buzzer.v, uart_gpio_buzzer_demo.v, uart_rx_8n1.v]
2026-10-08 Remove deprecated files and scripts from ros_robot_controller package
    - Deleted udev rules file for ttyACM0 to streamline device management.
    - Removed script for creating udev rules as it is no longer necessary.
    - Eliminated the main ROS node script (ros_robot_controller_node.py) to simplify the package.
    - Cleared setup.py as the package structure has changed.
    - Removed SDK implementation (ros_robot_controller_sdk.py) as it is no longer in use.
    - Deleted service definitions for GetBusServoState and GetPWMServoState as they are obsolete.
    [calibrate_params.yaml, hiwonder_servo_controller.yaml, hiwonder_servo_controller_without_arm.yaml]
